intergalaktik/SynthoGame/(notices)

Notices in the files:
SynthoGame/SynthoGame_bottom/audio.sch:
Copyright 2018 Santiago Germino (see LICENCE)
